parkourlrc/pcb-fsanzeni--FSC-BT1104QI-Breakout-af219c3d26/schematic.pdf

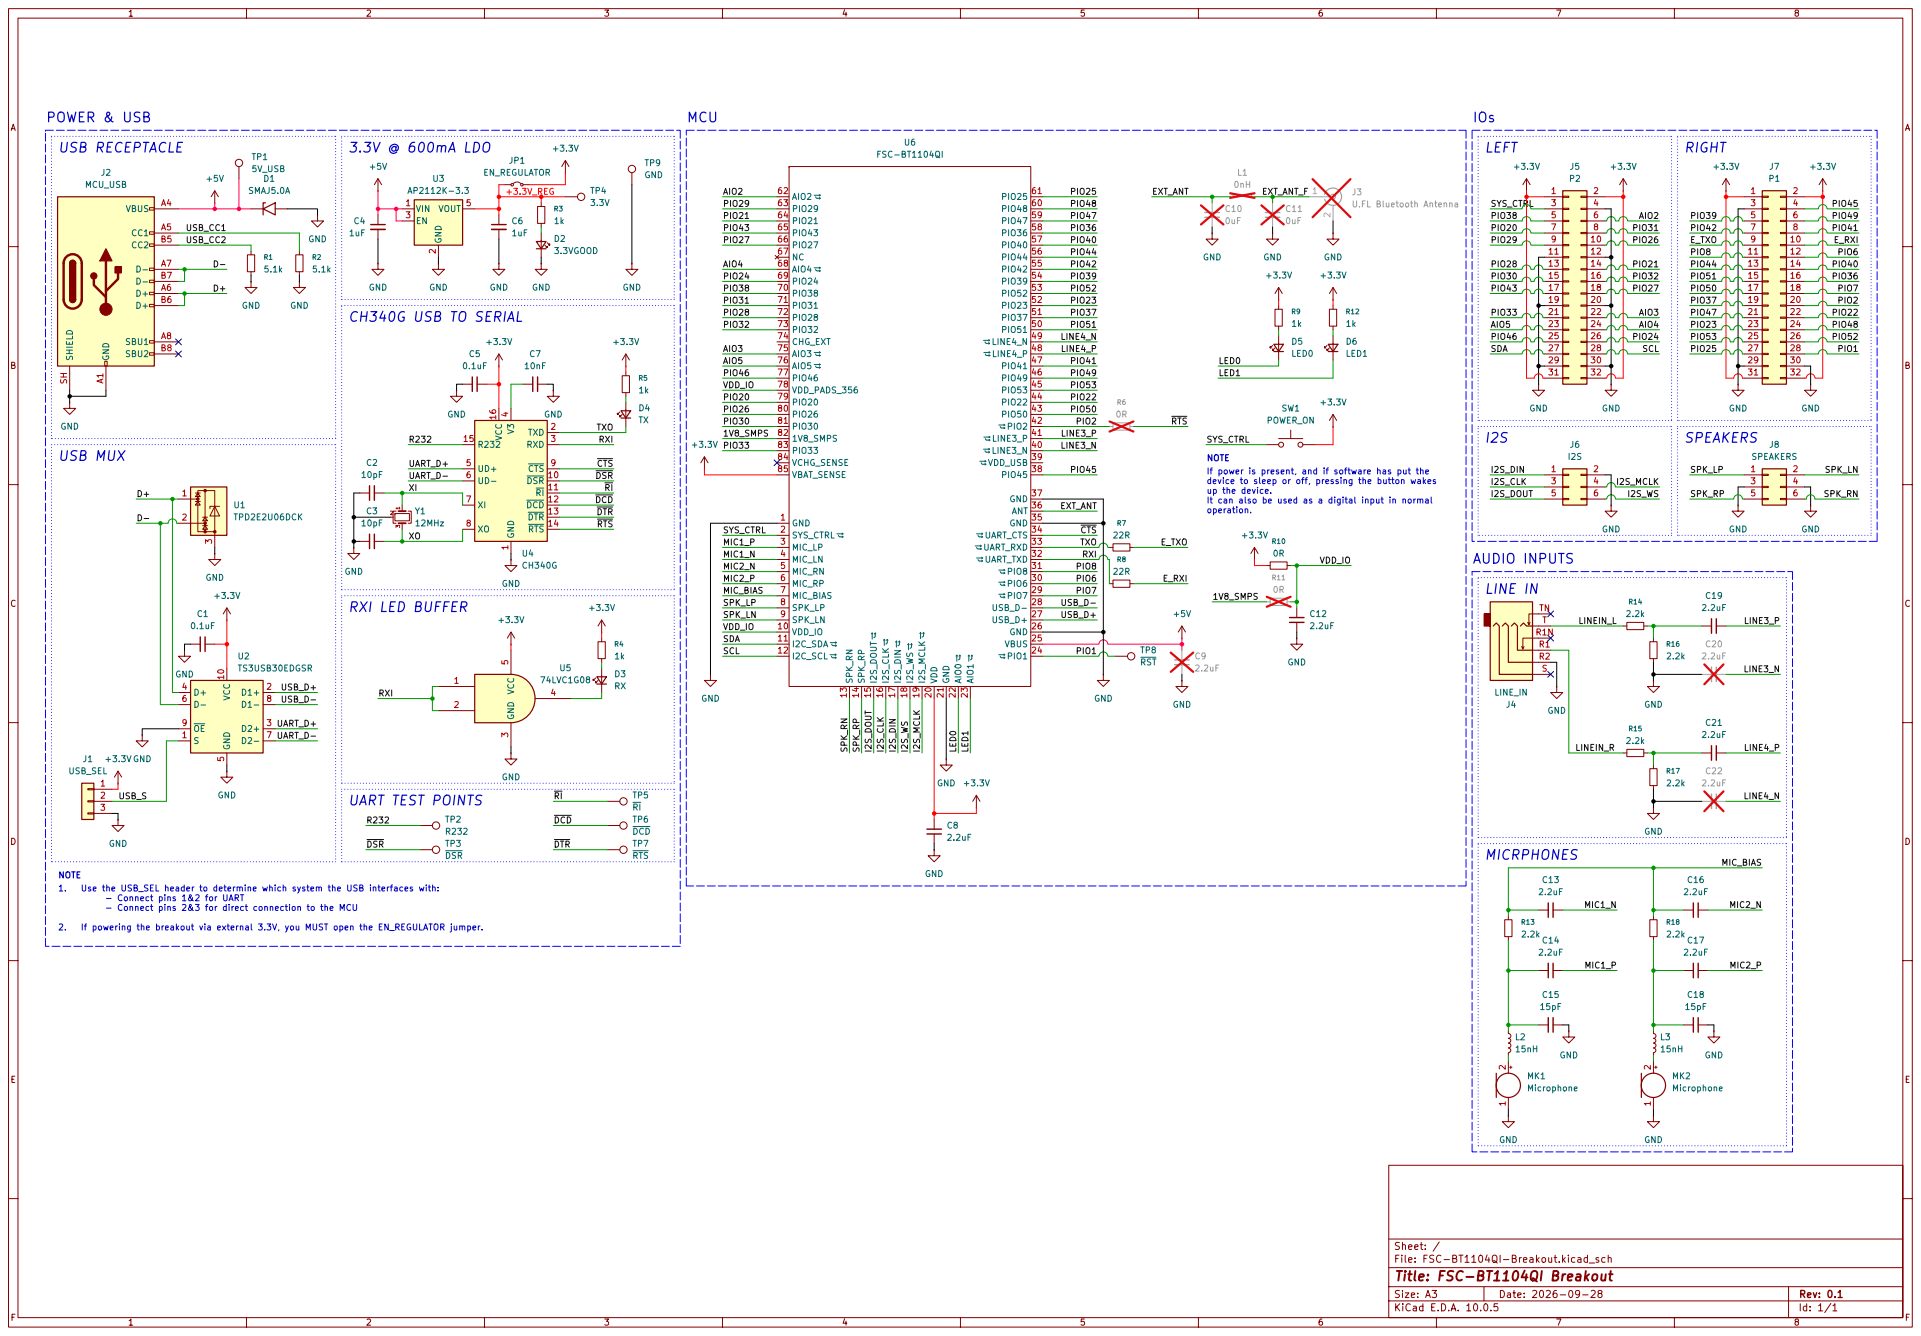
[picture p3: page 1]
