parkourlrc/pcb-fsanzeni--FSC-BT1104QI-Breakout-af219c3d26/FSC-BT1104QI-Breakout.kicad_pcb

## KiCad design FSC-BT1104QI-Breakout.kicad_pcb (2026-09-28)

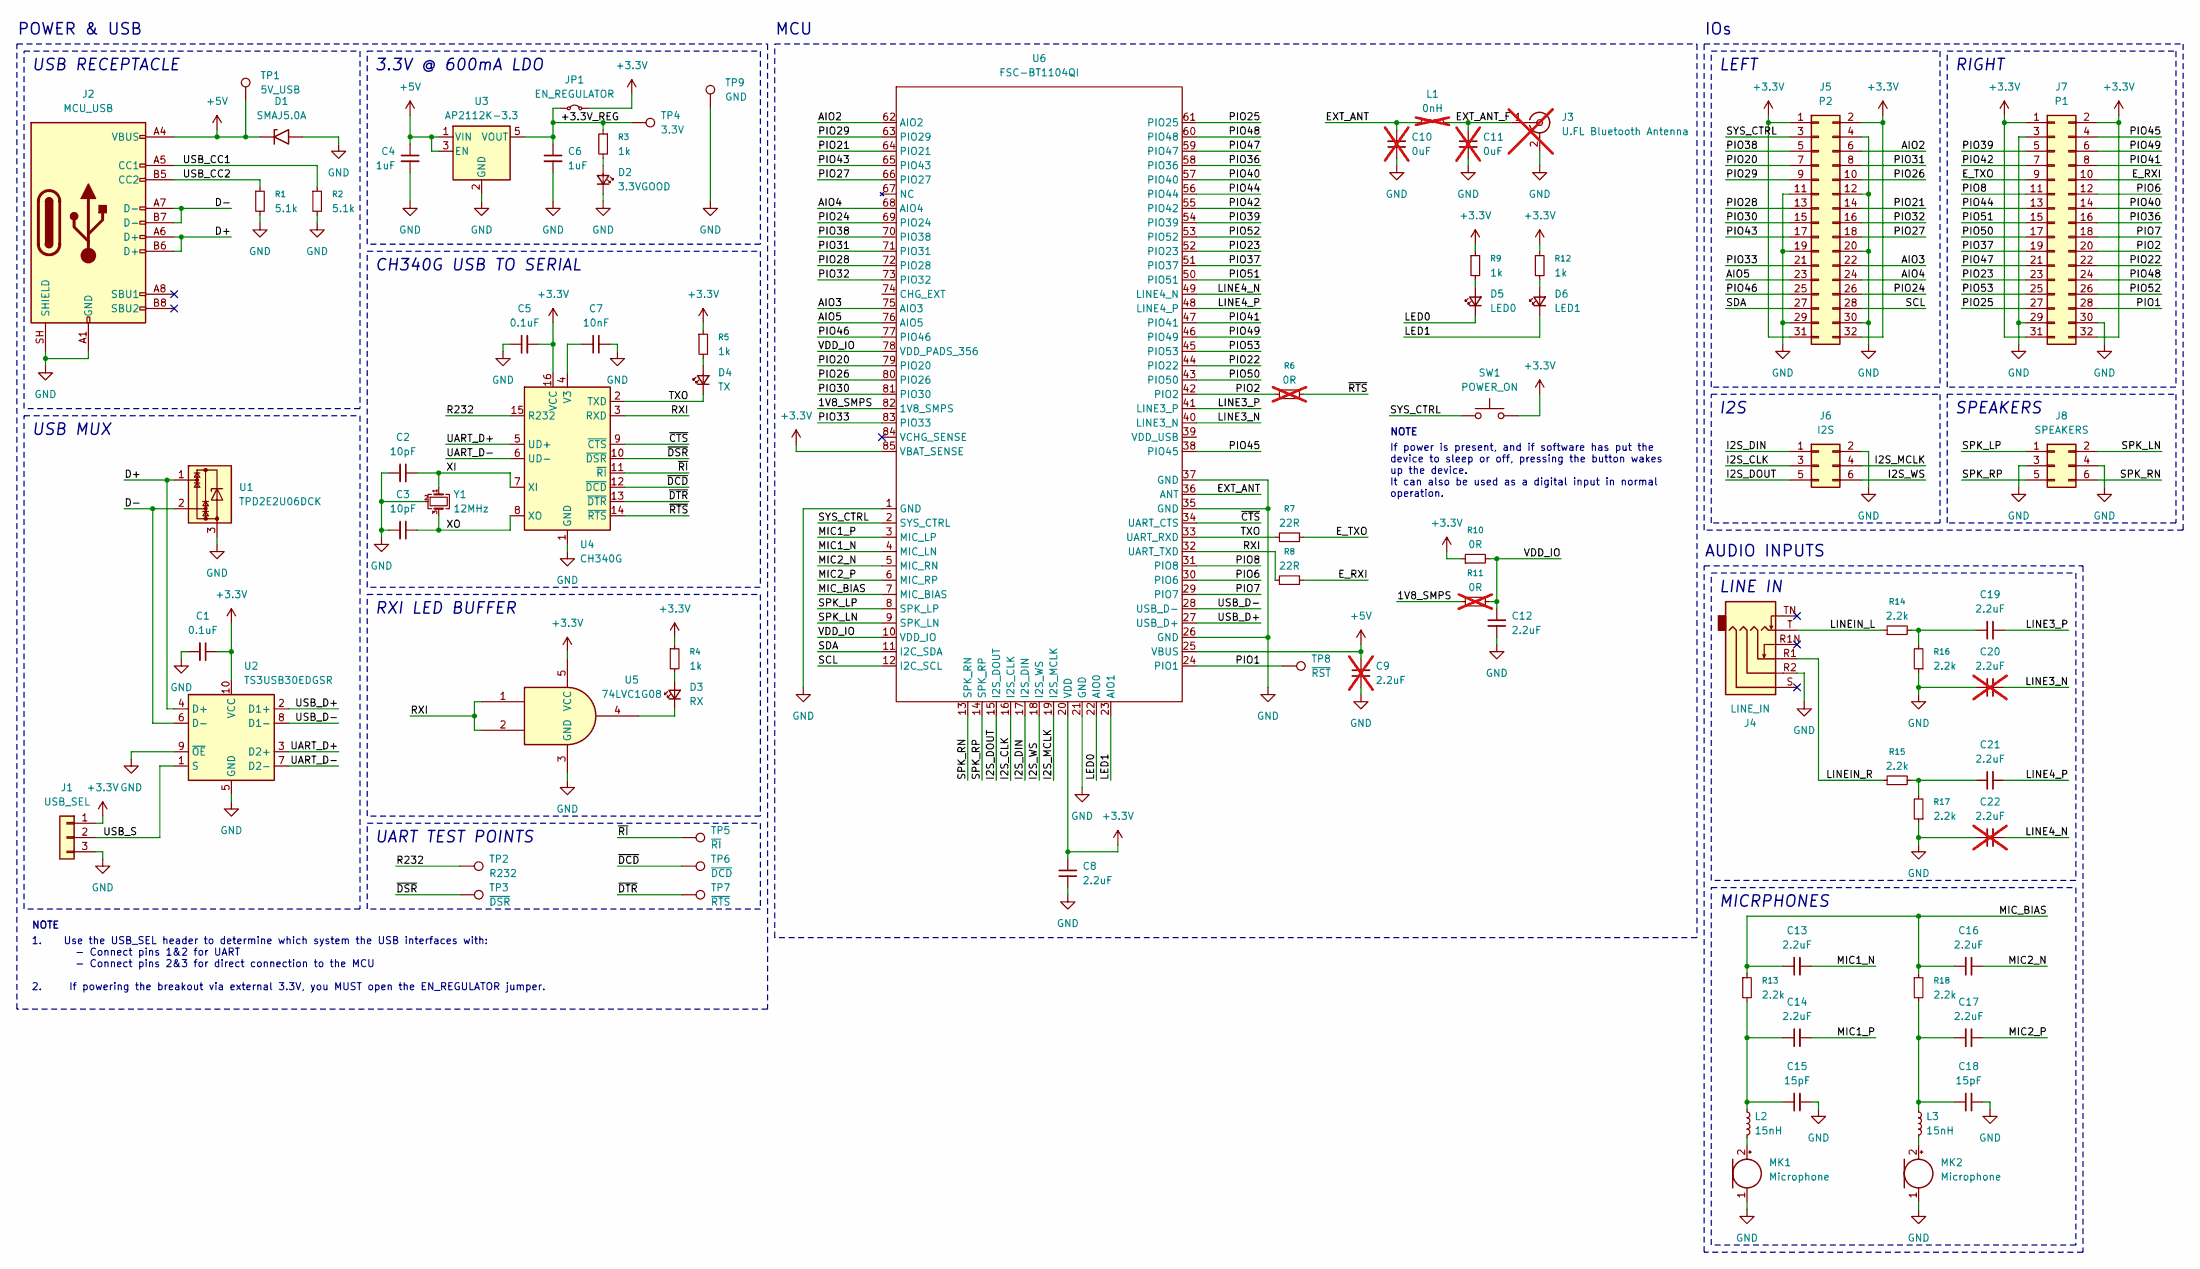
[picture p4: schematic FSC-BT1104QI-Breakout.kicad_sch, FSC-BT1104QI Breakout]

Parts:
C1, C5: 0.1uF; C_0603_1608Metric
C2, C3: 10pF; C_0603_1608Metric
C4, C6: 1uF; C_0805_2012Metric
C7: 10nF; C_0603_1608Metric
C8, C12, C13, C14, C16, C17, C19, C21: 2.2uF; C_0603_1608Metric
C9, C20, C22: 2.2uF; C_0603_1608Metric; not fitted
C10, C11: 0uF; C_0603_1608Metric; not fitted
C15, C18: 15pF; C_0603_1608Metric
D1: SMAJ5.0A; D_SMA
D2: 3.3VGOOD; LED_0603_1608Metric
D3: RX; LED_0603_1608Metric
D4: TX; LED_0603_1608Metric
D5: LED0; LED_0603_1608Metric
D6: LED1; LED_0603_1608Metric
J1: USB_SEL; PinHeader_1x03_P2.54mm_Vertical
J2: MCU_USB; SHOUHAN_TYPE-C_16PIN_2MD__073
J3: U.FL Bluetooth Antenna; U.FL_Molex_MCRF_73412-0110_Vertical; not fitted
J4: LINE_IN; Jack_3.5mm_PJ31060-I_Horizontal
J5: P2; PinHeader_2x16_P2.54mm_Vertical
J6: I2S; PinHeader_2x03_P2.54mm_Vertical
J7: P1; PinHeader_2x16_P2.54mm_Vertical
J8: SPEAKERS; PinHeader_2x03_P2.54mm_Vertical
JP1: EN_REGULATOR; PinHeader_1x02_P2.54mm_Vertical
L1: 0nH; L_0603_1608Metric; not fitted
L2, L3: 15nH; L_0603_1608Metric
MK1, MK2: Microphone; GMI4015P-2C-42db
R1, R2: 5.1k; R_0603_1608Metric
R3, R4, R5, R9, R12: 1k; R_0603_1608Metric
R6, R11: 0R; R_0603_1608Metric; not fitted
R7, R8: 22R; R_0603_1608Metric
R10: 0R; R_0603_1608Metric
R13, R14, R15, R16, R17, R18: 2.2k; R_0603_1608Metric
SW1: POWER_ON; SW_Push_1P1T_NO_CK_KMR2
TP1: 5V_USB; TestPoint_Pad_D1.5mm
TP2: R232; TestPoint_Pad_D1.5mm
TP3: ~{DSR}; TestPoint_Pad_D1.5mm
TP4: 3.3V; TestPoint_Pad_D1.5mm
TP5: ~{RI}; TestPoint_Pad_D1.5mm
TP6: ~{DCD}; TestPoint_Pad_D1.5mm
TP7: ~{RTS}; TestPoint_Pad_D1.5mm
TP8: ~{RST}; TestPoint_Pad_D1.5mm
TP9: GND; TestPoint_Pad_D1.5mm
U1: TPD2E2U06DCK; SOT-323_SC-70
U2: TS3USB30EDGSR; TSSOP-10_3x3mm_P0.5mm
U3: AP2112K-3.3; SOT-23-5
U4: CH340G; SOIC-16_3.9x9.9mm_P1.27mm
U5: 74LVC1G08; SOT-23-5
U6: FSC-BT1104QI
Y1: 12MHz; TAXM12M4RLBDDT2T

Connections:
+3.3V: C1.2, C5.2, C8.2, J1.1, J5.1, J5.2, J5.31, J5.32, J7.1, J7.2, J7.31, J7.32, JP1.2 (B), R4.1, R5.1, R9.1, R10.1, R12.1, SW1.2, U2.10 (VCC), U4.16 (VCC), U5.5 (VCC), U6.20 (VDD), U6.85 (VBAT_SENSE)
+5V: C4.1, C9.2, D1.1 (A1), J2.A4 (VBUS), J2.A9 (VBUS), J2.B4 (VBUS), J2.B9 (VBUS), TP1.1 (1_1), U3.1 (VIN), U3.3 (EN), U6.25 (VBUS)
/1V8_SMPS: R11.1, U6.82 (1V8_SMPS)
/+3.3V_REG: C6.1, JP1.1 (A), R3.1, TP4.1 (1_1), U3.5 (VOUT)
/AIO2: J5.6, U6.62 (AIO2)
/AIO3: J5.22, U6.75 (AIO3)
/AIO4: J5.24, U6.68 (AIO4)
/AIO5: J5.23, U6.76 (AIO5)
/D+: J2.A6 (D+), J2.B6 (D+), U1.1, U2.4 (D+)
/D-: J2.A7 (D-), J2.B7 (D-), U1.2, U2.6 (D-)
/EXT_ANT: C10.2, L1.1, U6.36 (ANT)
/EXT_ANT_F: C11.2, J3.1 (In), L1.2
/E_RXI: J7.10, R8.2
/E_TXO: J7.9, R7.2
/I2S_CLK: J6.3, U6.16 (I2S_CLK)
/I2S_DIN: J6.1, U6.17 (I2S_DIN)
/I2S_DOUT: J6.5, U6.15 (I2S_DOUT)
/I2S_MCLK: J6.4, U6.19 (I2S_MCLK)
/I2S_WS: J6.6, U6.18 (I2S_WS)
/LED0: D5.1 (K), U6.22 (AIO0)
/LED1: D6.1 (K), U6.23 (AIO1)
/LINE3_N: C20.2, U6.40 (LINE3_N)
/LINE3_P: C19.2, U6.41 (LINE3_P)
/LINE4_N: C22.2, U6.49 (LINE4_N)
/LINE4_P: C21.2, U6.48 (LINE4_P)
/LINEIN_L: J4.T, R14.1
/LINEIN_R: J4.R1, R15.1
/MIC1_N: C13.2, U6.4 (MIC_LN)
/MIC1_P: C14.2, U6.3 (MIC_LP)
/MIC2_N: C16.2, U6.5 (MIC_RN)
/MIC2_P: C17.2, U6.6 (MIC_RP)
/MIC_BIAS: C13.1, C16.1, R13.1, R18.1, U6.7 (MIC_BIAS)
/PIO1: J7.28, TP8.1 (1_1), U6.24 (PIO1)
/PIO2: J7.20, R6.1, U6.42 (PIO2)
/PIO6: J7.12, U6.30 (PIO6)
/PIO7: J7.18, U6.29 (PIO7)
/PIO8: J7.11, U6.31 (PIO8)
/PIO20: J5.7, U6.79 (PIO20)
/PIO21: J5.14, U6.64 (PIO21)
/PIO22: J7.22, U6.44 (PIO22)
/PIO23: J7.23, U6.52 (PIO23)
/PIO24: J5.26, U6.69 (PIO24)
/PIO25: J7.27, U6.61 (PIO25)
/PIO26: J5.10, U6.80 (PIO26)
/PIO27: J5.18, U6.66 (PIO27)
/PIO28: J5.13, U6.72 (PIO28)
/PIO29: J5.9, U6.63 (PIO29)
/PIO30: J5.15, U6.81 (PIO30)
/PIO31: J5.8, U6.71 (PIO31)
/PIO32: J5.16, U6.73 (PIO32)
/PIO33: J5.21, U6.83 (PIO33)
/PIO36: J7.16, U6.58 (PIO36)
/PIO37: J7.19, U6.51 (PIO37)
/PIO38: J5.5, U6.70 (PIO38)
/PIO39: J7.5, U6.54 (PIO39)
/PIO40: J7.14, U6.57 (PIO40)
/PIO41: J7.8, U6.47 (PIO41)
/PIO42: J7.7, U6.55 (PIO42)
/PIO43: J5.17, U6.65 (PIO43)
/PIO44: J7.13, U6.56 (PIO44)
/PIO45: J7.4, U6.38 (PIO45)
/PIO46: J5.25, U6.77 (PIO46)
/PIO47: J7.21, U6.59 (PIO47)
/PIO48: J7.24, U6.60 (PIO48)
/PIO49: J7.6, U6.46 (PIO49)
/PIO50: J7.17, U6.43 (PIO50)
/PIO51: J7.15, U6.50 (PIO51)
/PIO52: J7.26, U6.53 (PIO52)
/PIO53: J7.25, U6.45 (PIO53)
/R232: TP2.1 (1_1), U4.15 (R232)
/RXI: R8.1, U4.3 (RXD), U5.1, U5.2, U6.32 (UART_TXD)
/SCL: J5.28, U6.12 (I2C_SCL)
/SDA: J5.27, U6.11 (I2C_SDA)
/SPK_LN: J8.2, U6.9 (SPK_LN)
/SPK_LP: J8.1, U6.8 (SPK_LP)
/SPK_RN: J8.6, U6.13 (SPK_RN)
/SPK_RP: J8.5, U6.14 (SPK_RP)
/SYS_CTRL: J5.3, SW1.1, U6.2 (SYS_CTRL)
/TXO: D4.1 (K), R7.1, U4.2 (TXD), U6.33 (UART_RXD)
/UART_D+: U2.3 (D2+), U4.5 (UD+)
/UART_D-: U2.7 (D2-), U4.6 (UD-)
/USB_CC1: J2.A5 (CC1), R2.1
/USB_CC2: J2.B5 (CC2), R1.1
/USB_D+: U2.2 (D1+), U6.27 (USB_D+)
/USB_D-: U2.8 (D1-), U6.28 (USB_D-)
/USB_S: J1.2, U2.1 (S)
/VDD_IO: C12.1, R10.2, R11.2, U6.10 (VDD_IO), U6.78 (VDD_PADS_356)
/XI: C2.2, U4.7 (XI), Y1.1
/XO: C3.2, U4.8 (XO), Y1.3
/~CTS: U4.9 (~CTS), U6.34 (UART_CTS)
/~DCD: TP6.1 (1_1), U4.12 (~DCD)
/~DSR: TP3.1 (1_1), U4.10 (~DSR)
/~DTR: TP7.1 (1_1), U4.13 (~DTR)
/~RI: TP5.1 (1_1), U4.11 (~RI)
/~RTS: R6.2, U4.14 (~RTS)
GND: C1.1, C2.1, C3.1, C4.2, C5.1, C6.2, C7.2, C8.1, C9.1, C10.1, C11.1, C12.2, C15.2, C18.2, C20.1, C22.1, D1.2 (A2), D2.1 (K), J1.3, J2.A1 (GND), J2.A12 (GND), J2.B1 (GND), J2.B12 (GND), J2.SH (SHIELD), J3.2 (Ext), J4.R2, J5.4, J5.11, J5.12, J5.19, J5.20, J5.29, J5.30, J6.2, J7.3, J7.29, J7.30, J8.3, J8.4, MK1.1 (-), MK2.1 (-), R1.2, R2.2, R16.1, R17.1, TP9.1 (1_1), U1.3, U2.5 (GND), U2.9 (~OE), U3.2 (GND), U4.1 (GND), U5.3 (GND), U6.1 (GND), U6.21 (GND), U6.26 (GND), U6.35 (GND), U6.37 (GND), Y1.2 (G), Y1.4 (G)
unnamed: C14.1, C15.1, L2.1, R13.2
unnamed: C17.1, C18.1, L3.1, R18.2
unnamed: C19.1, R14.2, R16.2
unnamed: C21.1, R15.2, R17.2
unnamed: D2.2 (A), R3.2
unnamed: D3.2 (A), R4.2
unnamed: D3.1 (K), U5.4
unnamed: D4.2 (A), R5.2
unnamed: D5.2 (A), R9.2
unnamed: D6.2 (A), R12.2
unnamed: L2.2, MK1.2 (+)
unnamed: L3.2, MK2.2 (+)
unnamed: C7.1, U4.4 (V3)

Notes on the sheet:
MICRPHONES
UART TEST POINTS
IOs
LEFT
I2S
LINE IN
RIGHT
NOTE
MCU
CH340G USB TO SERIAL
POWER & USB
3.3V @ 600mA LDO
1. Use the USB_SEL header to determine which system the USB interfaces with: - Connect pins 1&2 for UART - Connect pins 2&3 for direct connection to the MCU 2. If powering the breakout via external 3.3V, you MUST open the EN_REGULATOR jumper.
USB RECEPTACLE
USB MUX
AUDIO INPUTS
RXI LED BUFFER
SPEAKERS
If power is present, and if software has put the device to sleep or off, pressing the button wakes up the device. It can also be used as a digital input in normal operation.

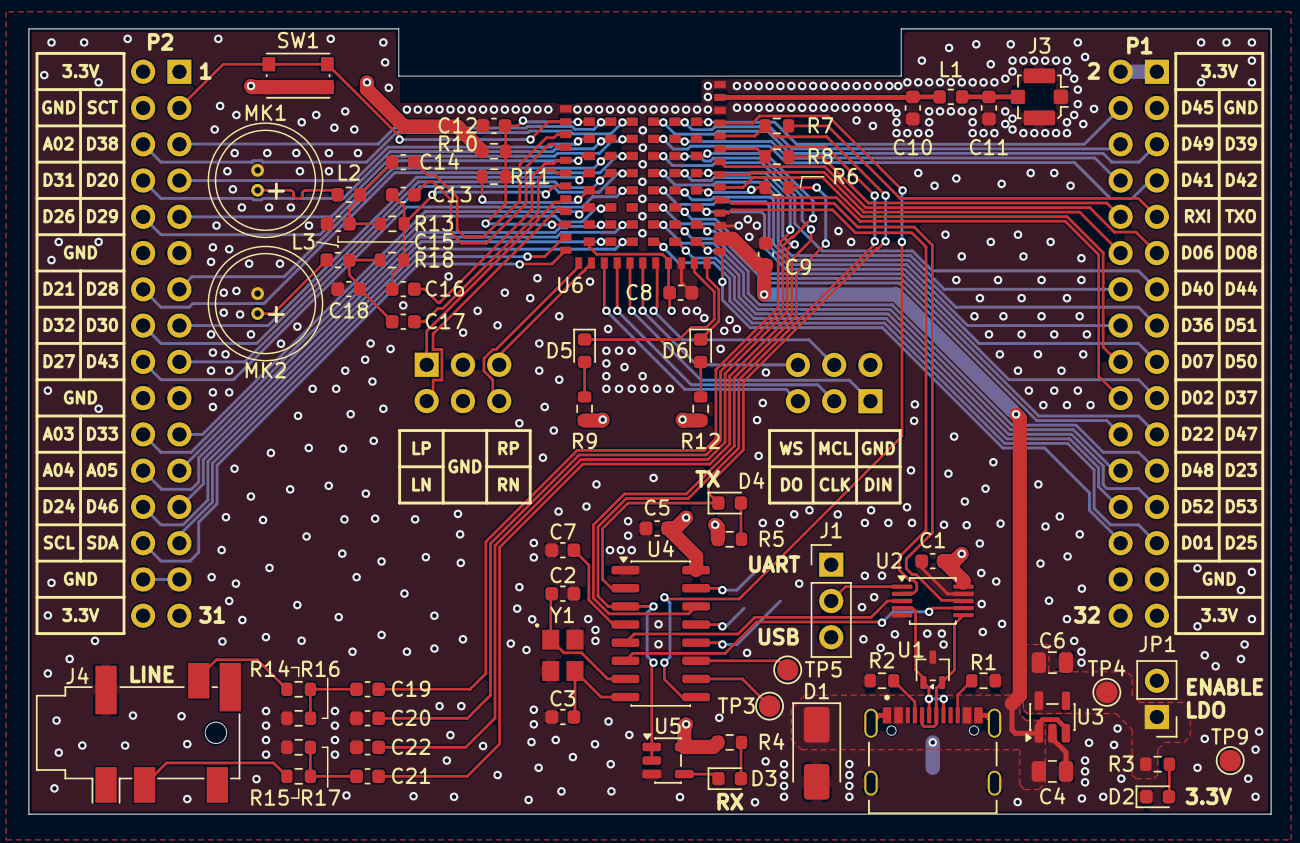
[picture p5: board FSC-BT1104QI-Breakout.kicad_pcb from above]

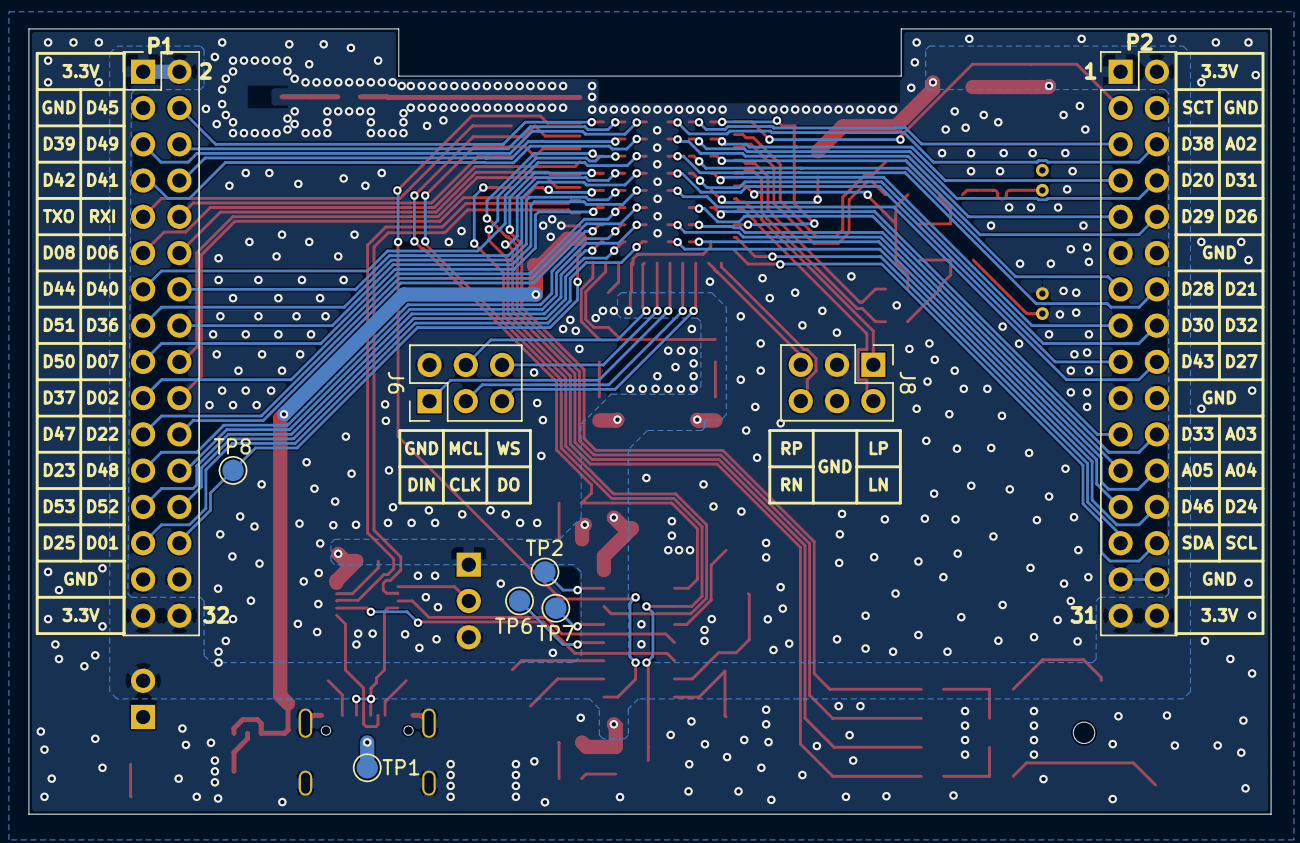
[picture p6: board FSC-BT1104QI-Breakout.kicad_pcb from below]

Board: 4 copper layers, 87.0 x 55.0 mm, 77 parts (9 on the bottom side), 109 nets.
